KagasiraBunJee/stm32_oscilloscope/Services/README.md

# Services

System-level interfaces and communication buses live here. The current
implementations adapt the board's FSMC/DMA LCD bus and bit-banged touch bus to
the board-agnostic ILI9341 and XPT2046 component drivers.
