KagasiraBunJee/stm32_oscilloscope/hardware/easyeda/output/rev3_copper.png

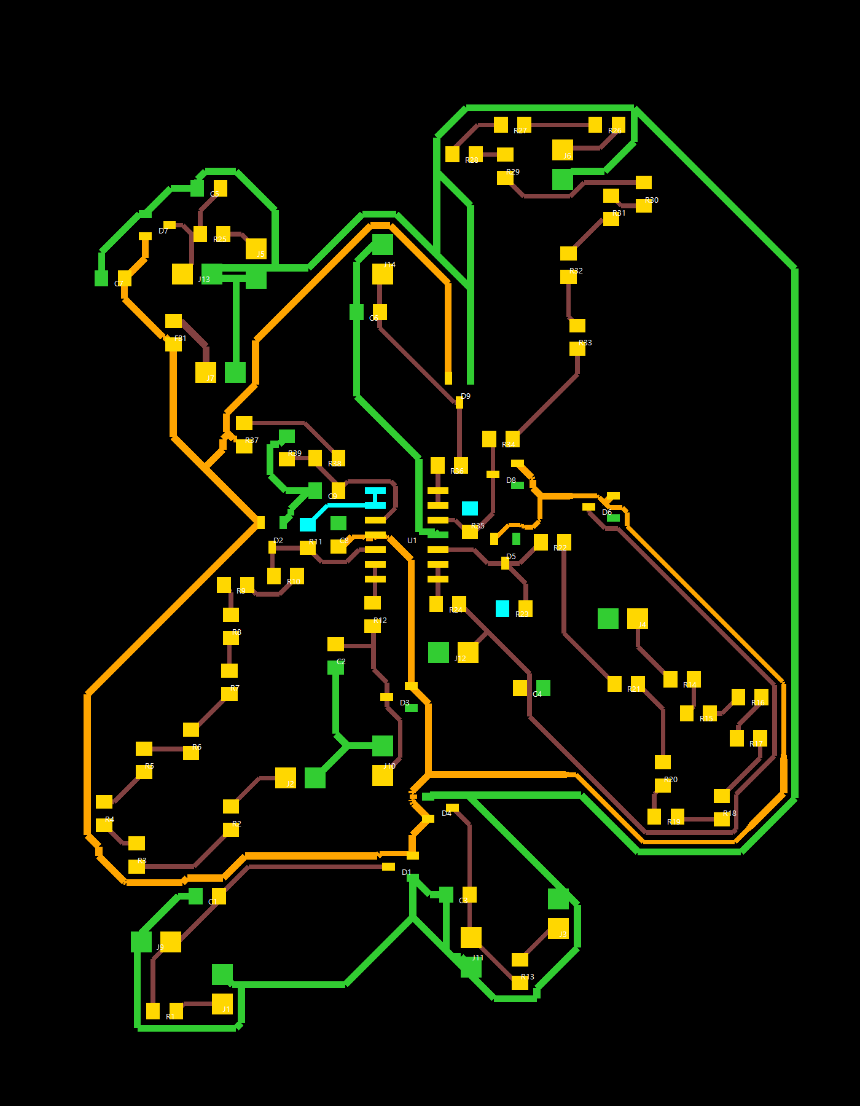
hardware/easyeda/output/rev3_copper.png
