KagasiraBunJee/stm32_oscilloscope/hardware/easyeda/output/rev3_placement_preview.png

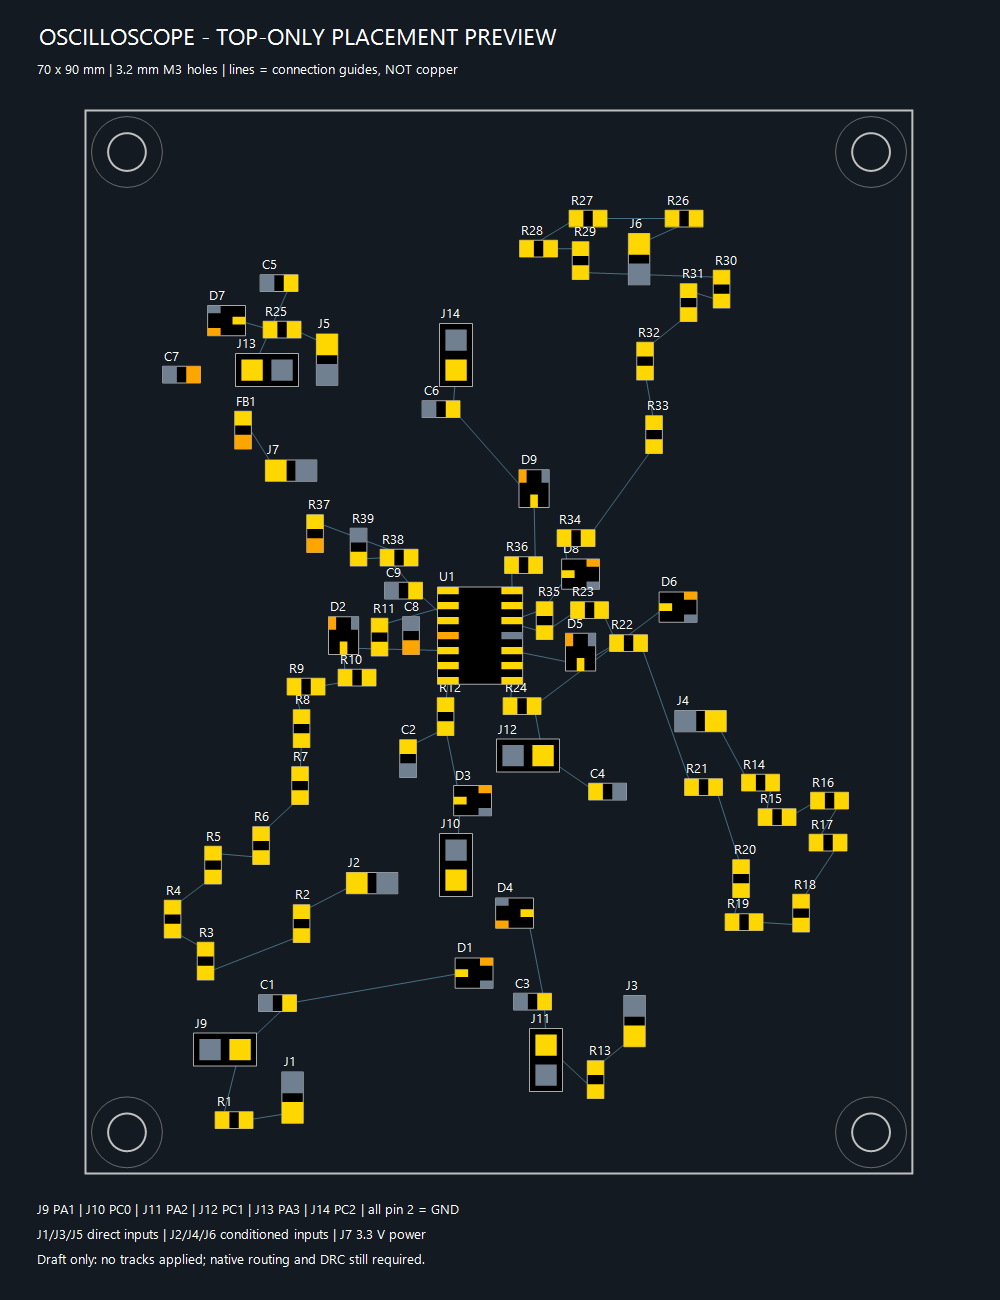
hardware/easyeda/output/rev3_placement_preview.png
