KagasiraBunJee/stm32_oscilloscope/hardware/mcp6022/mcp6022_1n4148_schematic.png

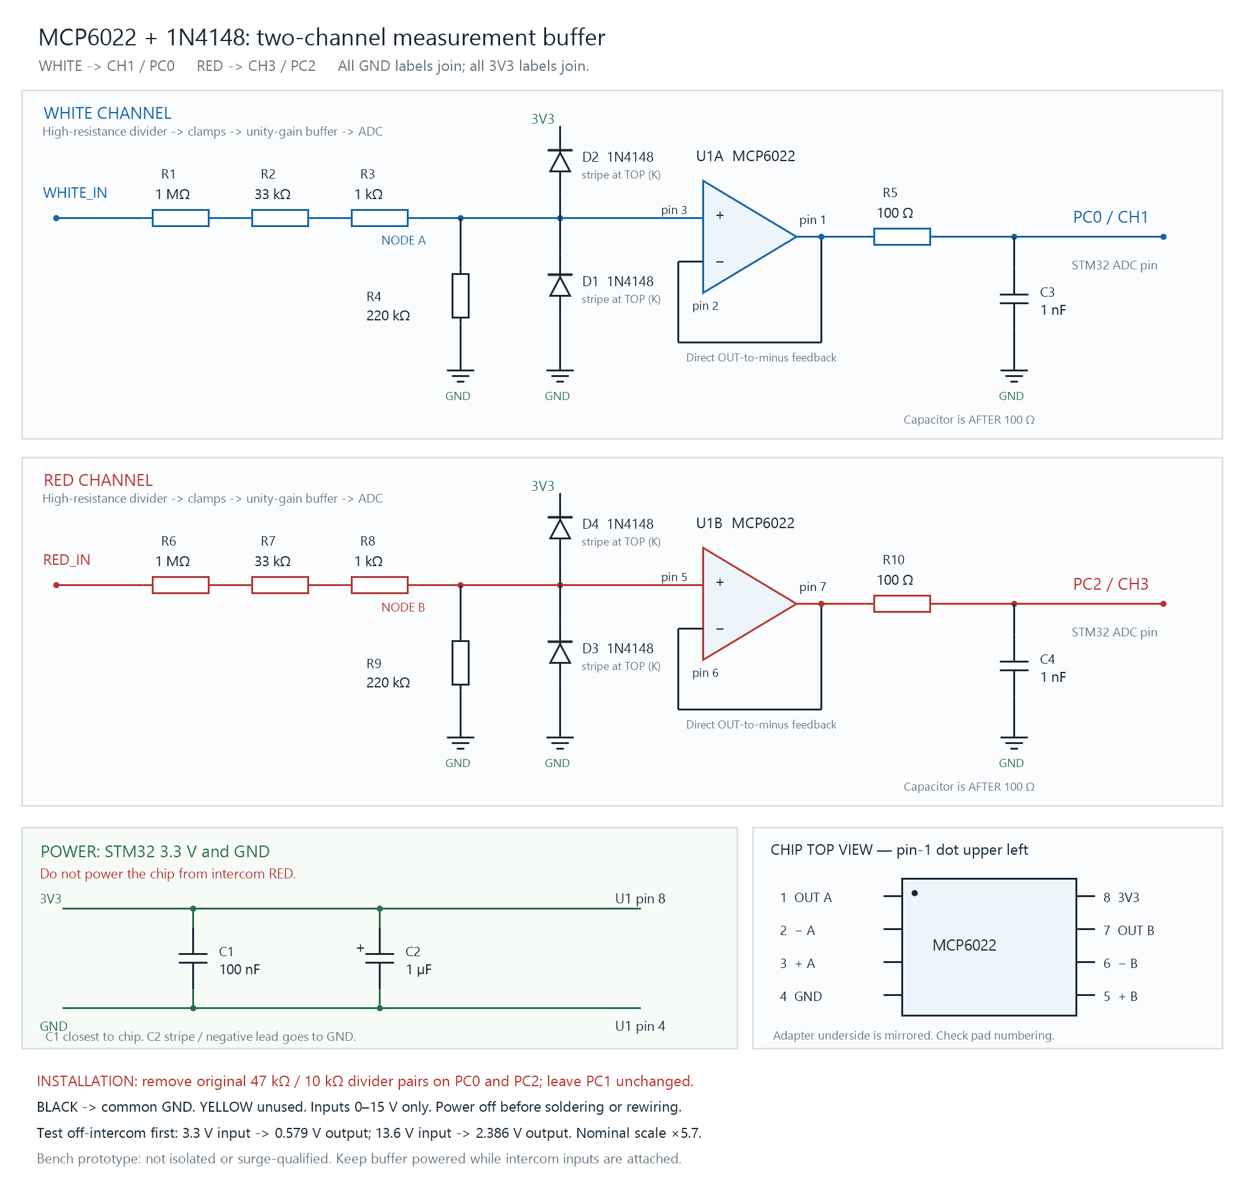
hardware/mcp6022/mcp6022_1n4148_schematic.png
