KagasiraBunJee/stm32_oscilloscope/hardware/receive_audio/receive_audio_breadboard.png

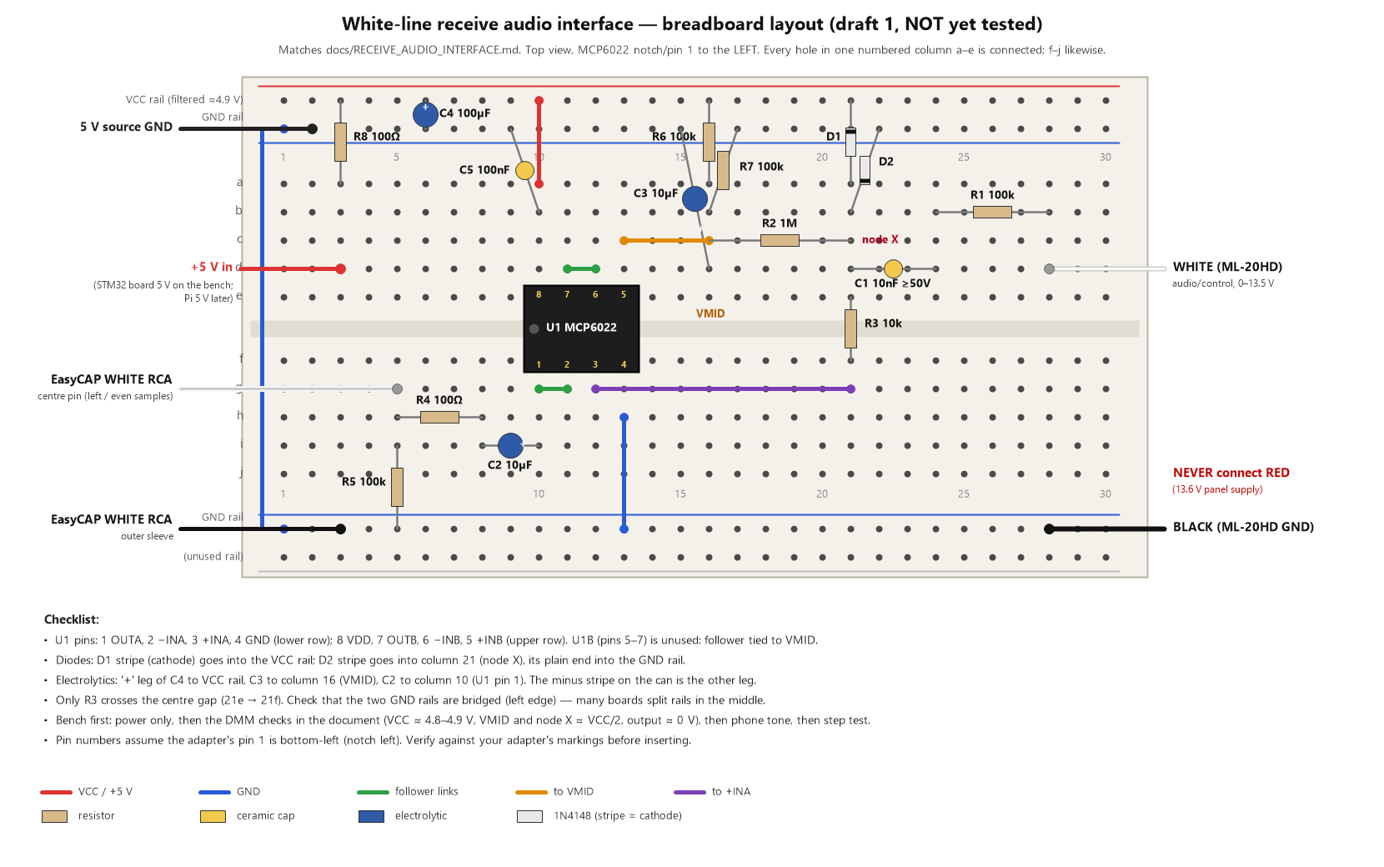
hardware/receive_audio/receive_audio_breadboard.png
