KagasiraBunJee/stm32_oscilloscope/Info_ImportChanges_analog_front_end_schematic_2026-09-07.csv

Change | Action | Object | Before import | After import
C1
✓ | Modify Device | C0805:Device | C0805 | 1nF
C2
✓ | Modify Device | C0805:Device | C0805 | 1nF
C3
✓ | Modify Device | C0805:Device | C0805 | 1nF
C4
✓ | Modify Device | C0805:Device | C0805 | 1nF
C5
✓ | Modify Device | C0805:Device | C0805 | 1nF
C6
✓ | Modify Device | C0805:Device | C0805 | 1nF
C7
✓ | Modify Device | C0805:Device | C0805 | 10uF
C8
✓ | Modify Footprint | C0805:Footprint | C0805 | C0805
C9
✓ | Modify Footprint | C0805:Footprint | C0805 | C0805
D1
✓ | Modify Device | SOT23:Device | SOT23 | BAT54S
D2
✓ | Modify Footprint | SOT23:Footprint | SOT23 | SOT23
D3
✓ | Modify Footprint | SOT23:Footprint | SOT23 | SOT23
D4
✓ | Modify Device | SOT23:Device | SOT23 | BAT54S
D5
✓ | Modify Footprint | SOT23:Footprint | SOT23 | SOT23
D6
✓ | Modify Footprint | SOT23:Footprint | SOT23 | SOT23
D7
✓ | Modify Footprint | SOT23:Footprint | SOT23 | SOT23
D8
✓ | Modify Footprint | SOT23:Footprint | SOT23 | SOT23
D9
✓ | Modify Footprint | SOT23:Footprint | SOT23 | SOT23
FB1
✓ | Modify Device | R0805:Device | R0805 | Ferrite 600R@100MHz
J1
✓ | Modify Device | HDR1X2:Device | HDR1X2 | CH1 DIRECT 0-3.3V
J2
✓ | Modify Device | HDR1X2:Device | HDR1X2 | CH1 HIGH +/-15V
J3
✓ | Modify Device | HDR1X2:Device | HDR1X2 | CH2 DIRECT 0-3.3V
J4
✓ | Modify Device | HDR1X2:Device | HDR1X2 | CH2 HIGH +/-15V
J5
✓ | Modify Device | HDR1X2:Device | HDR1X2 | CH3 DIRECT 0-3.3V
J6
✓ | Modify Device | HDR1X2:Device | HDR1X2 | CH3 HIGH +/-15V
J7
✓ | Modify Device | HDR1X2:Device | HDR1X2 | POWER 3.3V
J8
✓ | Modify Device | HDR2X4:Device | HDR2X4 | STM32 OUTPUTS
R1
✓ | Modify Device | R0805:Device | R0805 | 100R
R2
✓ | Modify Device | R0805:Device | R0805 | 100k
R3
✓ | Modify Footprint | R0805:Footprint | R0805 | R0805
R4
✓ | Modify Device | R0805:Device | R0805 | 100k
R5
✓ | Modify Device | R0805:Device | R0805 | 100k
R6
✓ | Modify Footprint | R0805:Footprint | R0805 | R0805
R7
✓ | Modify Device | R0805:Device | R0805 | 100k
R8
✓ | Modify Footprint | R0805:Footprint | R0805 | R0805
R9
✓ | Modify Device | R0805:Device | R0805 | 100k
R10
✓ | Modify Device | R0805:Device | R0805 | 100k
R11
✓ | Modify Device | R0805:Device | R0805 | 100k
R12
✓ | Modify Device | R0805:Device | R0805 | 33R
R13
✓ | Modify Device | R0805:Device | R0805 | 100R
R14
✓ | Modify Device | R0805:Device | R0805 | 100k
R15
✓ | Modify Footprint | R0805:Footprint | R0805 | R0805
R16
✓ | Modify Device | R0805:Device | R0805 | 100k
R17
✓ | Modify Device | R0805:Device | R0805 | 100k
R18
✓ | Modify Footprint | R0805:Footprint | R0805 | R0805
R19
✓ | Modify Device | R0805:Device | R0805 | 100k
R20
✓ | Modify Footprint | R0805:Footprint | R0805 | R0805
R21
✓ | Modify Device | R0805:Device | R0805 | 100k
R22
✓ | Modify Device | R0805:Device | R0805 | 100k
R23
✓ | Modify Device | R0805:Device | R0805 | 100k
R24
✓ | Modify Device | R0805:Device | R0805 | 33R
R25
✓ | Modify Device | R0805:Device | R0805 | 100R
R26
✓ | Modify Device | R0805:Device | R0805 | 100k
R27
✓ | Modify Footprint | R0805:Footprint | R0805 | R0805
R28
✓ | Modify Device | R0805:Device | R0805 | 100k
R29
✓ | Modify Device | R0805:Device | R0805 | 100k
R30
✓ | Modify Footprint | R0805:Footprint | R0805 | R0805
R31
✓ | Modify Device | R0805:Device | R0805 | 100k
R32
✓ | Modify Footprint | R0805:Footprint | R0805 | R0805
R33
✓ | Modify Device | R0805:Device | R0805 | 100k
R34
✓ | Modify Device | R0805:Device | R0805 | 100k
R35
✓ | Modify Device | R0805:Device | R0805 | 100k
R36
✓ | Modify Device | R0805:Device | R0805 | 33R
R37
✓ | Modify Device | R0805:Device | R0805 | 40k
R38
✓ | Modify Device | R0805:Device | R0805 | 40k
R39
✓ | Modify Footprint | R0805:Footprint | R0805 | R0805
U1
✓ | Modify Device | SOIC14:Device | SOIC14 | TLV9064IDR
Design Rule
 | Add Design Rule | TrackPhysics:copperThickness1oz | - | copperThickness1oz
 | Add Design Rule | TrackPhysics:copperThickness2oz | - | copperThickness2oz
 | Delete Design Rule | TrackPhysics:Default | Default | -
