KagasiraBunJee/stm32_oscilloscope/App/Assets/oscilloscope_test_320x240.png

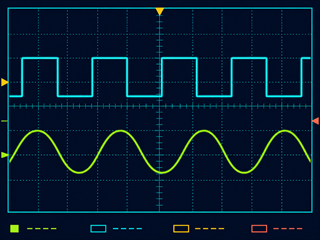
App/Assets/oscilloscope_test_320x240.png
