KagasiraBunJee/stm32_oscilloscope/peripheral_docs/3.2inch_MRB3205_Size.pdf

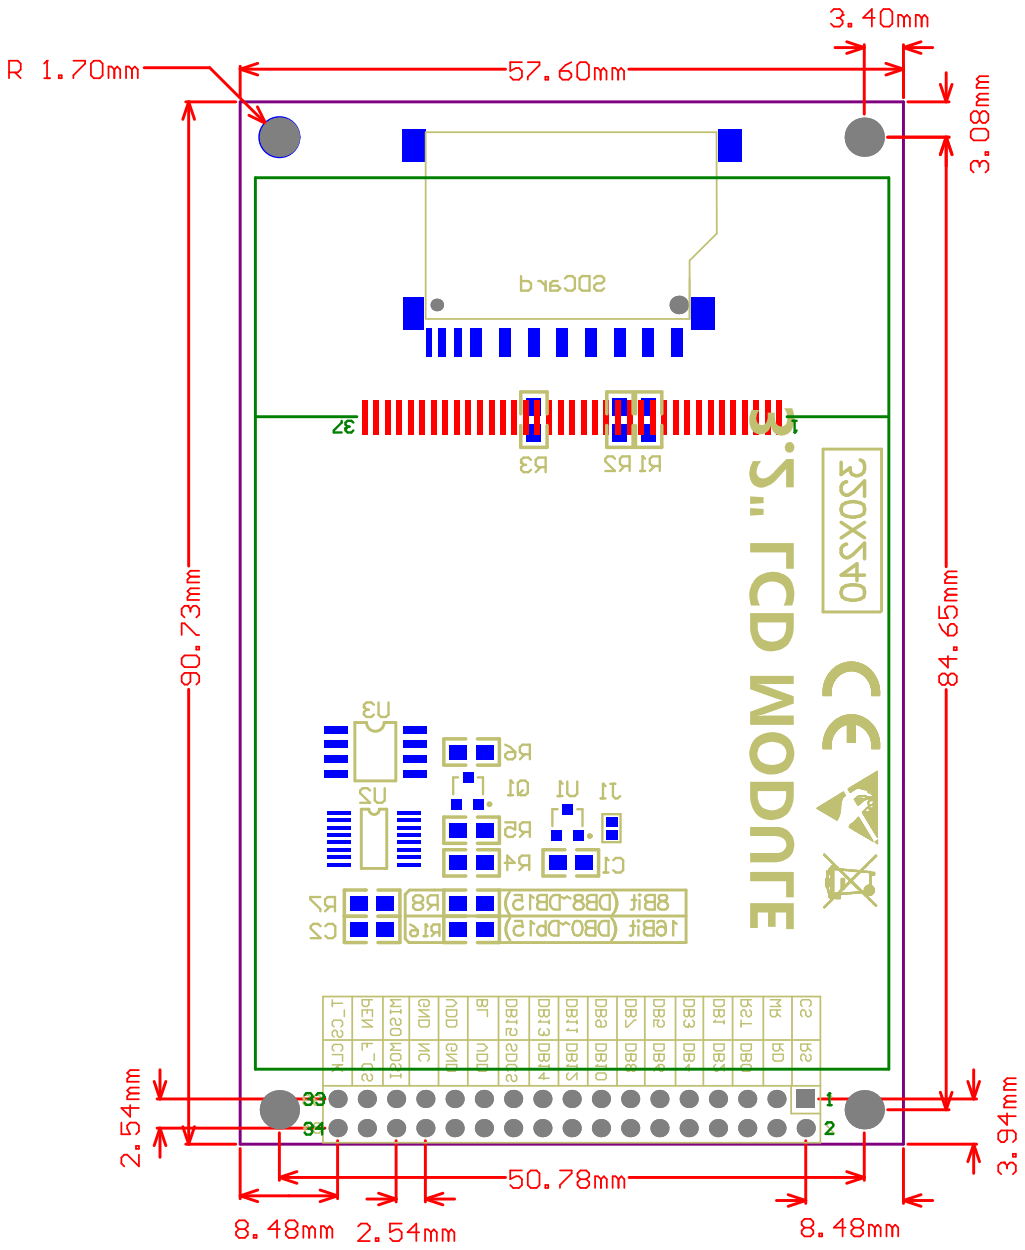
[picture p6: page 1]
