KagasiraBunJee/stm32_oscilloscope/(list of files, drawings)

Other design files:
hardware/mcp6022/schematic_scene.json
