KagasiraBunJee/stm32_oscilloscope/Core/Src/board.c

#include "board.h"
#include "stm32f4xx_hal.h"

bool board_clock_init(void)
{
    RCC_OscInitTypeDef oscillator = {0};
    RCC_ClkInitTypeDef clocks = {0};

    __HAL_RCC_PWR_CLK_ENABLE();
    __HAL_PWR_VOLTAGESCALING_CONFIG(PWR_REGULATOR_VOLTAGE_SCALE1);

    oscillator.OscillatorType = RCC_OSCILLATORTYPE_HSE;
    oscillator.HSEState = RCC_HSE_ON;
    oscillator.PLL.PLLState = RCC_PLL_ON;
    oscillator.PLL.PLLSource = RCC_PLLSOURCE_HSE;
    oscillator.PLL.PLLM = 8U;
    oscillator.PLL.PLLN = 288U;
    oscillator.PLL.PLLP = RCC_PLLP_DIV2;
    oscillator.PLL.PLLQ = 6U;
    if (HAL_RCC_OscConfig(&oscillator) != HAL_OK) {
        return false;
    }

    clocks.ClockType = RCC_CLOCKTYPE_SYSCLK | RCC_CLOCKTYPE_HCLK |
                       RCC_CLOCKTYPE_PCLK1 | RCC_CLOCKTYPE_PCLK2;
    clocks.SYSCLKSource = RCC_SYSCLKSOURCE_PLLCLK;
    clocks.AHBCLKDivider = RCC_SYSCLK_DIV1;
    clocks.APB1CLKDivider = RCC_HCLK_DIV4;
    clocks.APB2CLKDivider = RCC_HCLK_DIV2;
    if (HAL_RCC_ClockConfig(&clocks, FLASH_LATENCY_4) != HAL_OK) {
        return false;
    }

    SystemCoreClockUpdate();
    return (SystemCoreClock == BOARD_CORE_CLOCK_HZ);
}

void board_init(void)
{
    GPIO_InitTypeDef gpio = {0};

    __HAL_RCC_GPIOB_CLK_ENABLE();
    __HAL_RCC_GPIOC_CLK_ENABLE();
    __HAL_RCC_GPIOD_CLK_ENABLE();
    __HAL_RCC_GPIOE_CLK_ENABLE();
    __HAL_RCC_GPIOF_CLK_ENABLE();
    __HAL_RCC_GPIOG_CLK_ENABLE();

    gpio.Pin = GPIO_PIN_9 | GPIO_PIN_10;
    gpio.Mode = GPIO_MODE_OUTPUT_PP;
    gpio.Pull = GPIO_NOPULL;
    gpio.Speed = GPIO_SPEED_FREQ_LOW;
    HAL_GPIO_Init(GPIOF, &gpio);
    board_led_set(0, false);
    board_led_set(1, false);

    CoreDebug->DEMCR |= CoreDebug_DEMCR_TRCENA_Msk;
    DWT->CYCCNT = 0UL;
    DWT->CTRL |= DWT_CTRL_CYCCNTENA_Msk;
}

void board_delay_ms(uint32_t milliseconds)
{
    HAL_Delay(milliseconds);
}

uint32_t board_millis(void)
{
    return HAL_GetTick();
}

void board_led_set(uint32_t led, bool on)
{
    const uint16_t pin = (led == 0UL) ? GPIO_PIN_9 : GPIO_PIN_10;
    HAL_GPIO_WritePin(GPIOF, pin, on ? GPIO_PIN_RESET : GPIO_PIN_SET);
}

void board_led_toggle(uint32_t led)
{
    const uint16_t pin = (led == 0UL) ? GPIO_PIN_9 : GPIO_PIN_10;
    HAL_GPIO_TogglePin(GPIOF, pin);
}
